UCCR1/positioning-system/hardware/positioning_board.kicad_pcb

## KiCad design hardware/positioning_board.kicad_pcb (2026-02-25)

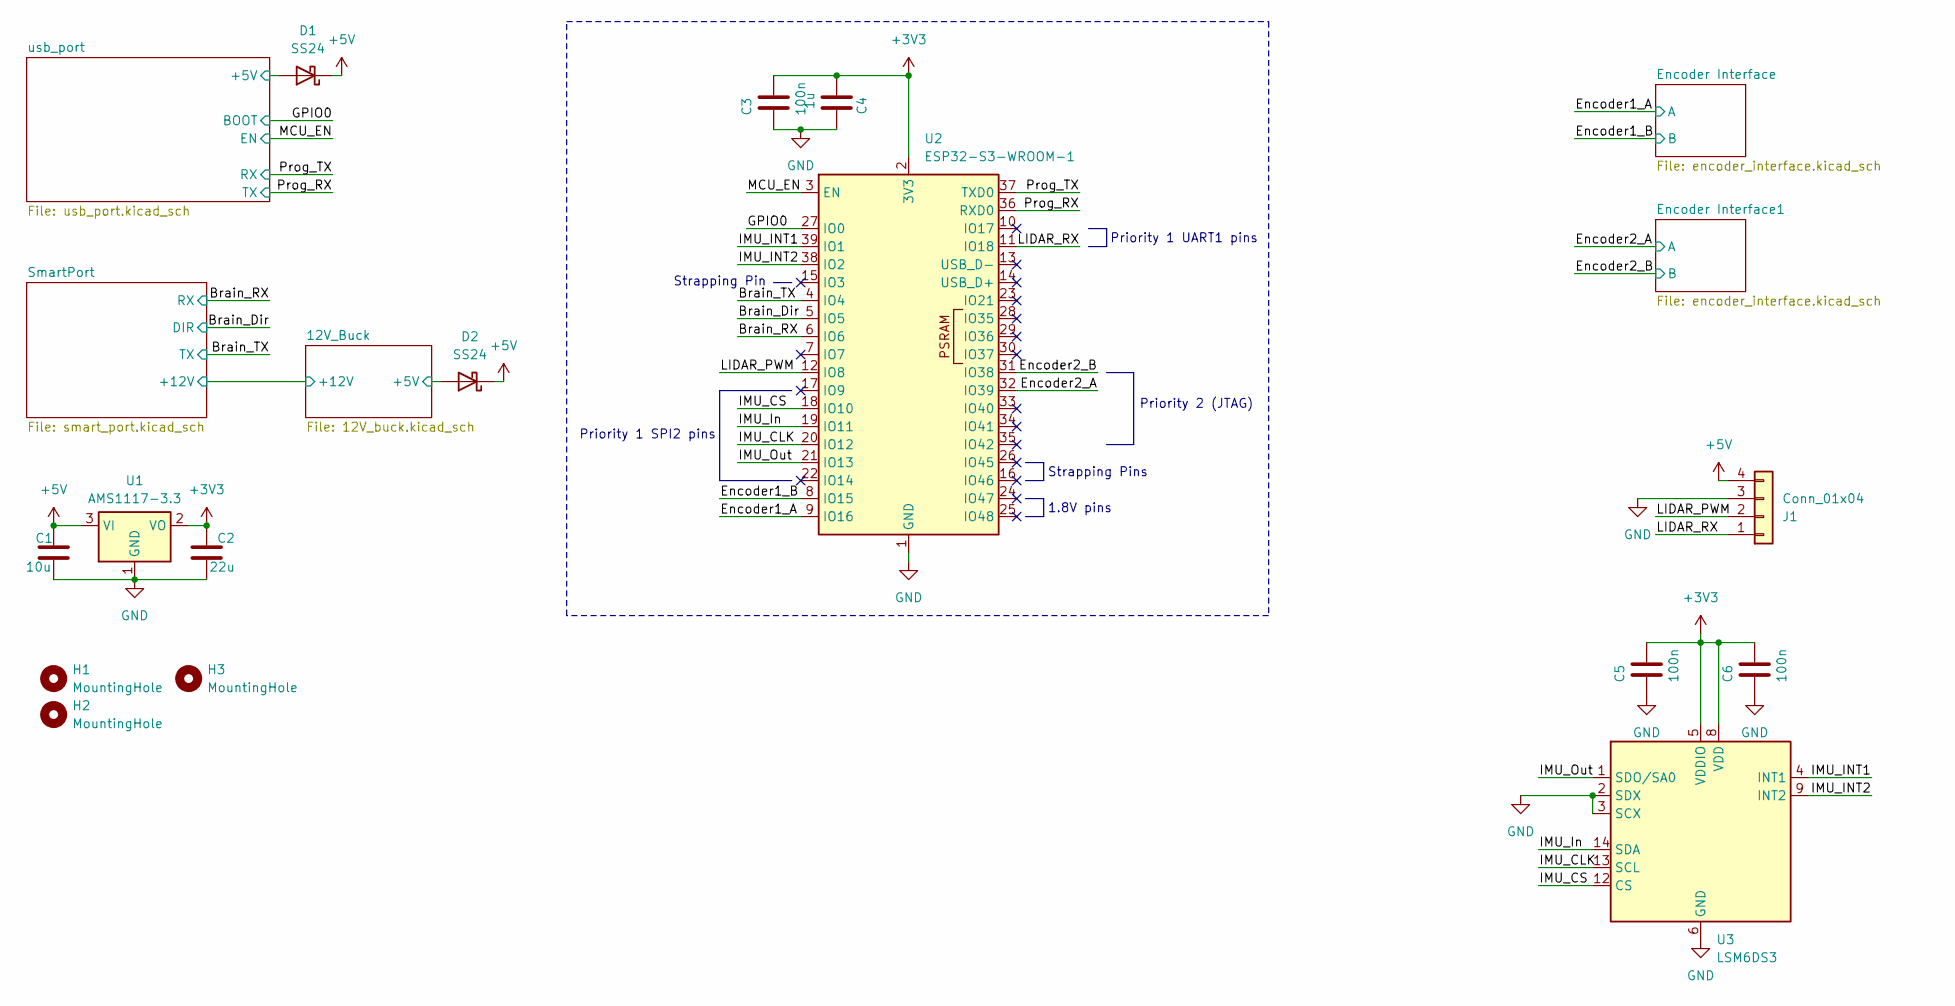
[picture p1: schematic positioning_board.kicad_sch]

Parts:
C1: 10u; C_0603_1608Metric
C2: 22u; C_0603_1608Metric
C3, C5, C6: 100n; C_0603_1608Metric
C4: 1u; C_0603_1608Metric
D1, D2: SS24; D_SMA; LCSC C2891713
H1, H2, H3: MountingHole; MountingHole_4.3mm_M4
J1: Conn_01x04; JST_ZH_B4B-ZR_1x04_P1.50mm_Vertical; LCSC C157997
U1: AMS1117-3.3; SOT-223-3_TabPin2; LCSC C6186
U2: ESP32-S3-WROOM-1; ESP32-S3-WROOM-1U; LCSC C3013946
U3: LSM6DS3; LGA-14_3x2.5mm_P0.5mm_LayoutBorder3x4y

Connections:
+3V3: C2.2, C3.2, C4.1, C5.2, C6.2, U1.2 (VO), U2.2 (3V3), U3.5 (VDDIO), U3.8 (VDD); also elsewhere on the board
+5V: C1.2, D1.1 (K), D2.1 (K), J1.4, U1.3 (VI); also elsewhere on the board
/12V_Buck/+5V: D2.2 (A); also elsewhere on the board
/Brain_Dir: U2.5 (IO5); also elsewhere on the board
/Brain_RX: U2.6 (IO6); also elsewhere on the board
/Brain_TX: U2.4 (IO4); also elsewhere on the board
/Encoder1_A: U2.9 (IO16); also elsewhere on the board
/Encoder1_B: U2.8 (IO15); also elsewhere on the board
/Encoder2_A: U2.32 (IO39); also elsewhere on the board
/Encoder2_B: U2.31 (IO38); also elsewhere on the board
/GPIO0: U2.27 (IO0); also elsewhere on the board
/IMU_CLK: U2.20 (IO12), U3.13 (SCL)
/IMU_CS: U2.18 (IO10), U3.12 (CS)
/IMU_INT1: U2.39 (IO1), U3.4 (INT1)
/IMU_INT2: U2.38 (IO2), U3.9 (INT2)
/IMU_In: U2.19 (IO11), U3.14 (SDA)
/IMU_Out: U2.21 (IO13), U3.1 (SDO/SA0)
/LIDAR_PWM: J1.2, U2.12 (IO8)
/LIDAR_RX: J1.1, U2.11 (IO18)
/MCU_EN: U2.3 (EN); also elsewhere on the board
/Prog_RX: U2.36 (RXD0); also elsewhere on the board
/Prog_TX: U2.37 (TXD0); also elsewhere on the board
/usb_port/+5V: D1.2 (A); also elsewhere on the board
GND: C1.1, C2.1, C3.1, C4.2, C5.1, C6.1, J1.3, U1.1 (GND), U2.1 (GND), U2.40 (GND), U2.41 (GND), U3.2 (SDX), U3.3 (SCX), U3.6 (GND), U3.7 (GND); also elsewhere on the board

Notes on the sheet:
Priority 2 (JTAG)
Strapping Pins
Strapping Pin
Priority 1 UART1 pins
1.8V pins
Priority 1 SPI2 pins

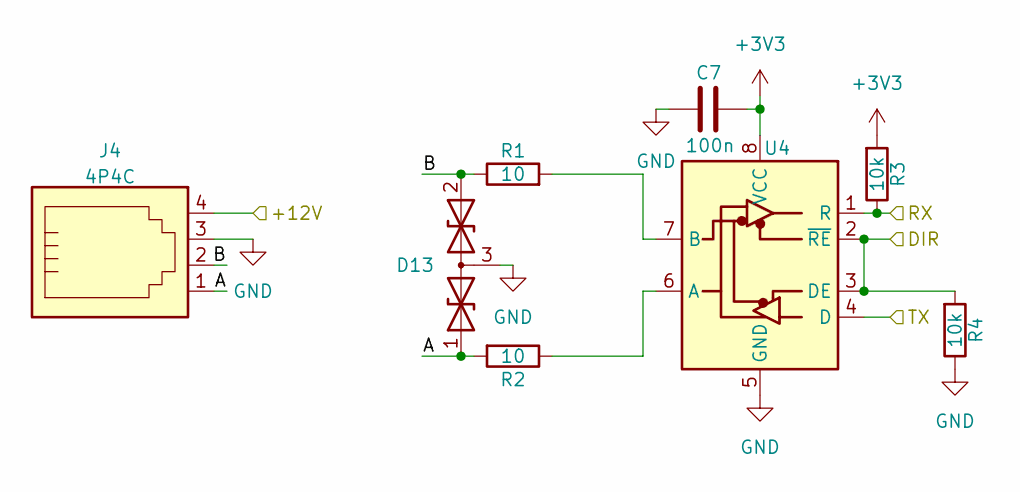
[picture p2: schematic smart_port.kicad_sch]

Parts:
C7: 100n; C_0603_1608Metric
D13: CESD3V3AP; SOT-23
J4: 4P4C; RJ11-4P4C; LCSC C189737
R1, R2: 10; R_0603_1608Metric
R3, R4: 10k; R_0603_1608Metric
U4: SN65HVD1782DR; SOIC-8_3.9x4.9mm_P1.27mm; LCSC C183092

Connections:
+3V3: C7.1, R3.2, U4.8 (VCC); also elsewhere on the board
/12V_Buck/+12V: J4.4; also elsewhere on the board
/Brain_Dir: R4.2, U4.2 (~RE), U4.3 (DE); also elsewhere on the board
/Brain_RX: R3.1, U4.1 (R); also elsewhere on the board
/Brain_TX: U4.4 (D); also elsewhere on the board
/SmartPort/A: D13.1 (A1), J4.1, R2.2
/SmartPort/B: D13.2 (A2), J4.2, R1.1
GND: C7.2, D13.3 (common), J4.3, R4.1, U4.5 (GND); also elsewhere on the board
unnamed: R2.1, U4.6 (A)
unnamed: R1.2, U4.7 (B)

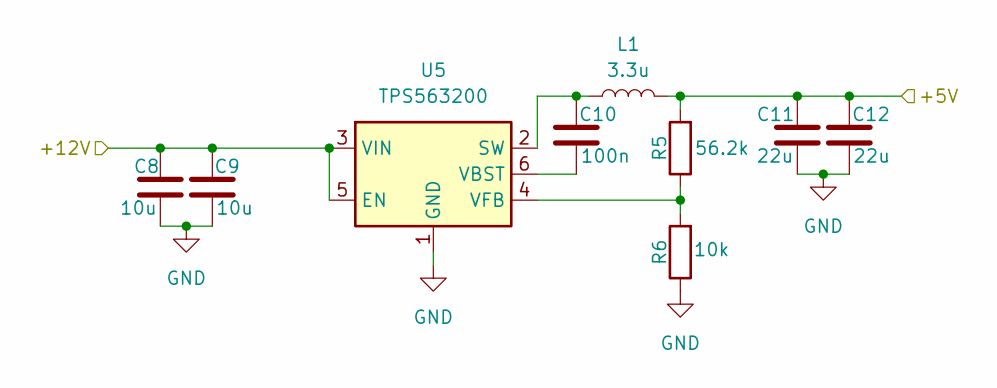
[picture p3: schematic 12V_buck.kicad_sch]

Parts:
C8, C9: 10u; C_0603_1608Metric
C10: 100n; C_0603_1608Metric
C11, C12: 22u; C_0603_1608Metric
L1: 3.3u; L_Changjiang_FXL0630; LCSC C167219
R5: 56.2k; R_0603_1608Metric
R6: 10k; R_0603_1608Metric
U5: TPS563200; SOT-23-6

Connections:
/12V_Buck/+5V: C11.2, C12.2, L1.2, R5.2; also elsewhere on the board
/12V_Buck/+12V: C8.2, C9.2, U5.3 (VIN), U5.5 (EN); also elsewhere on the board
GND: C8.1, C9.1, C11.1, C12.1, R6.1, U5.1 (GND); also elsewhere on the board
unnamed: C10.2, L1.1, U5.2 (SW)
unnamed: C10.1, U5.6 (VBST)
unnamed: R5.1, R6.2, U5.4 (VFB)

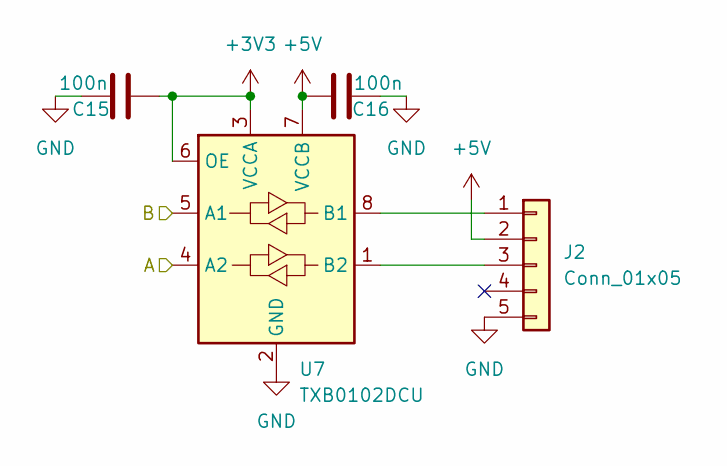
[picture p4: schematic encoder_interface.kicad_sch]

Parts:
C15, C16: 100n; C_0603_1608Metric
J2: Conn_01x05; JST_XH_S5B-XH-A_1x05_P2.50mm_Horizontal
U7: TXB0102DCU; VSSOP-8_2.3x2mm_P0.5mm

Connections:
+3V3: C15.1, U7.3 (VCCA), U7.6 (OE); also elsewhere on the board
+5V: C16.1, J2.2, U7.7 (VCCB); also elsewhere on the board
/Encoder1_A: U7.4 (A2); also elsewhere on the board
/Encoder1_B: U7.5 (A1); also elsewhere on the board
GND: C15.2, C16.2, J2.5, U7.2 (GND); also elsewhere on the board
unnamed: J2.1, U7.8 (B1)
unnamed: J2.3, U7.1 (B2)

Parts of its further copies:
C17, C18: 100n; C_0603_1608Metric
J3: Conn_01x05; JST_XH_S5B-XH-A_1x05_P2.50mm_Horizontal
U8: TXB0102DCU; VSSOP-8_2.3x2mm_P0.5mm

Connections of its further copies:
+3V3: C17.1, U8.3 (VCCA), U8.6 (OE); also elsewhere on the board
+5V: C18.1, J3.2, U8.7 (VCCB); also elsewhere on the board
/Encoder2_A: U8.4 (A2); also elsewhere on the board
/Encoder2_B: U8.5 (A1); also elsewhere on the board
GND: C17.2, C18.2, J3.5, U8.2 (GND); also elsewhere on the board
unnamed: J3.1, U8.8 (B1)
unnamed: J3.3, U8.1 (B2)

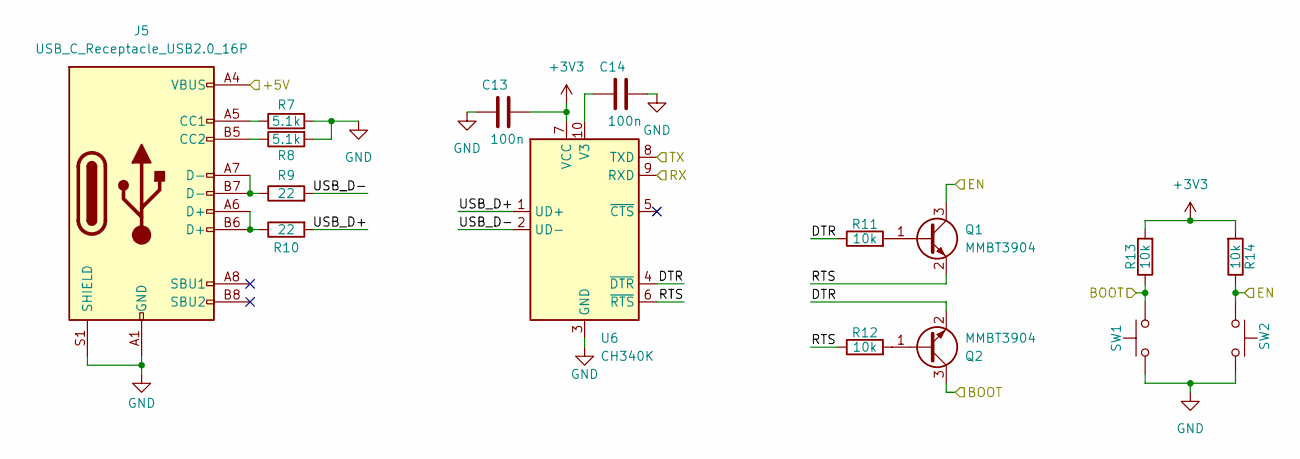
[picture p5: schematic usb_port.kicad_sch]

Parts:
C13, C14: 100n; C_0603_1608Metric
J5: USB_C_Receptacle_USB2.0_16P; USB_C_Receptacle_GCT_USB4105-xx-A_16P_TopMnt_Horizontal; LCSC C2927038
Q1, Q2: MMBT3904; SOT-23; LCSC C20526
R7, R8: 5.1k; R_0603_1608Metric
R9, R10: 22; R_0603_1608Metric
R11, R12, R13, R14: 10k; R_0603_1608Metric
SW1, SW2: SW_Push; SW_SPST_TS-1088-xR020; LCSC C720477
U6: CH340K; SSOP-10-1EP_3.9x4.9mm_P1mm_EP2.1x3.3mm; LCSC C968586

Connections:
+3V3: C13.2, R13.2, R14.2, U6.7 (VCC); also elsewhere on the board
/GPIO0: Q2.3 (C), R13.1, SW1.2; also elsewhere on the board
/MCU_EN: Q1.3 (C), R14.1, SW2.2; also elsewhere on the board
/Prog_RX: U6.8 (TXD); also elsewhere on the board
/Prog_TX: U6.9 (RXD); also elsewhere on the board
/usb_port/+5V: J5.A4 (VBUS), J5.A9 (VBUS), J5.B4 (VBUS), J5.B9 (VBUS); also elsewhere on the board
/usb_port/DTR: Q2.2 (E), R11.1, U6.4 (~DTR)
/usb_port/RTS: Q1.2 (E), R12.1, U6.6 (~RTS)
/usb_port/USB_D+: R10.2, U6.1 (UD+)
/usb_port/USB_D-: R9.2, U6.2 (UD-)
GND: C13.1, C14.2, J5.A1 (GND), J5.A12 (GND), J5.B1 (GND), J5.B12 (GND), J5.S1 (SHIELD), R7.2, R8.2, SW1.1, SW2.1, U6.3 (GND), U6.11 (GND); also elsewhere on the board
unnamed: J5.A5 (CC1), R7.1
unnamed: J5.B5 (CC2), R8.1
unnamed: J5.A6 (D+), J5.B6 (D+), R10.1
unnamed: J5.A7 (D-), J5.B7 (D-), R9.1
unnamed: Q1.1 (B), R11.2
unnamed: Q2.1 (B), R12.2
unnamed: C14.1, U6.10 (V3)

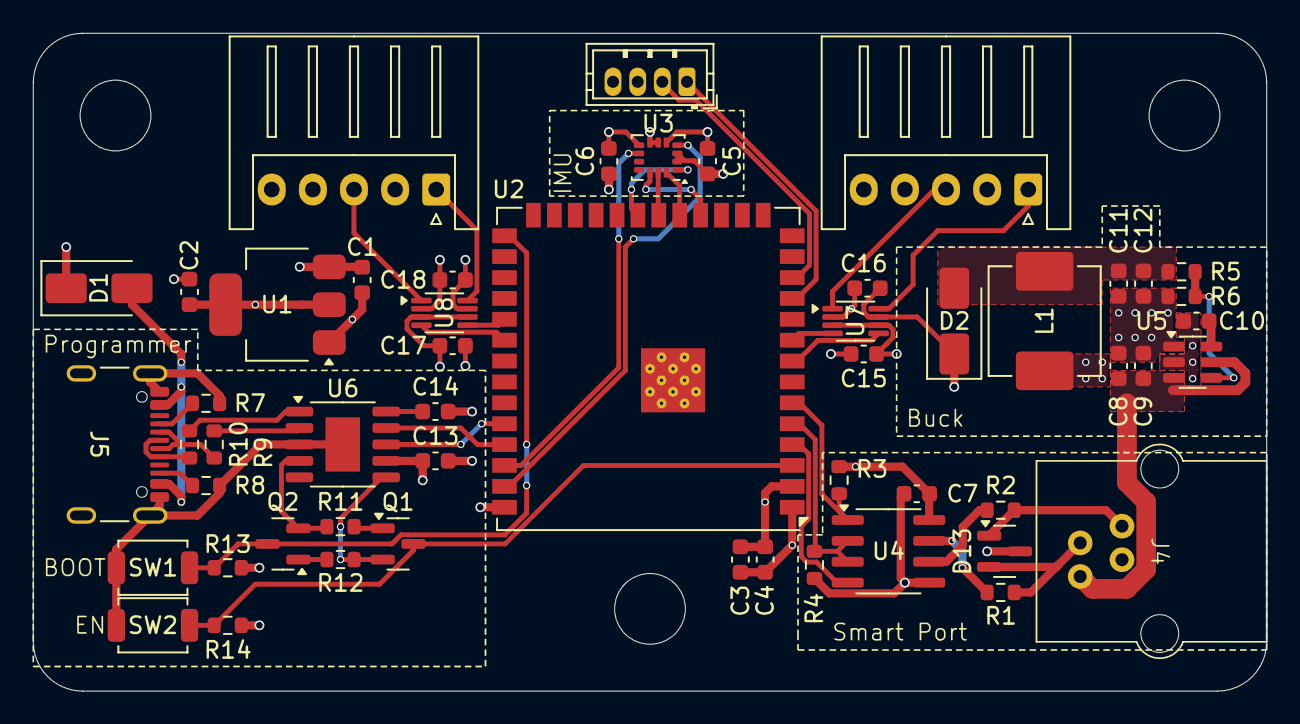
[picture p6: board positioning_board.kicad_pcb from above]

Board: 4 copper layers, 75.0 x 40.0 mm, 56 parts (0 on the bottom side), 47 nets.
