UCCR1/positioning-system/firmware/src/odometry.rs

use core::array;

use embassy_time::Timer;
use position_lib::odometry::{Odometry, TrackingWheel};
use uom::si::f32::{Angle, Length};

use crate::{encoder::QuadratureEncoder, imu::HEADING_SIGNAL};

pub struct OdometryTask<const N: usize> {
    module: Odometry<N>,

    wheel_diameter: Length,

    encoders: [QuadratureEncoder; N],
    last_angle: Angle,

    last_positions: [Angle; N],
}

impl<const N: usize> OdometryTask<N> {
    pub fn new(
        encoders: [QuadratureEncoder; N],
        wheels: [TrackingWheel; N],
        wheel_diameter: Length,
    ) -> Self {
        let module = Odometry::new(wheels);

        Self {
            module,
            encoders,
            wheel_diameter,

            last_angle: Default::default(),
            last_positions: [Default::default(); N],
        }
    }

    fn update(&mut self, new_angle: Angle) {
        let new_positions: [Angle; N] = array::from_fn(|i| self.encoders[i].position());

        let travels: [Length; N] = array::from_fn(|i| {
            (new_positions[i] - self.last_positions[i]) * self.wheel_diameter / 2.0
        });

        let angle_change = self.last_angle - new_angle; // TODO: Wrap this properly

        self.module.update(travels, angle_change);

        self.last_angle = new_angle;
        self.last_positions = new_positions;
    }

    pub async fn entrypoint(mut self) {
        loop {
            Timer::after_millis(10).await;

            let angle = HEADING_SIGNAL.wait().await;

            self.update(angle);
        }
    }
}

#[embassy_executor::task]
pub async fn start_odometry_task(task: OdometryTask<2>) {
    task.entrypoint().await;
}
