UCCR1/positioning-system/(commit log)

2026-02-11 add initial hardware
    [positioning_board.kicad_pcb, positioning_board.kicad_sch]
2026-02-23 feat: draft layout
    [positioning_board.kicad_pcb, positioning_board.kicad_sch]
2026-02-23 reroute lidar pins
    [positioning_board.kicad_pcb, positioning_board.kicad_sch]
2026-02-23 reroute some pins
    [positioning_board.kicad_pcb, positioning_board.kicad_sch]
2026-02-24 refactor into sub sheets
    [12V_buck.kicad_sch, positioning_board.kicad_sch, smart_port.kicad_sch, usb_port.kicad_sch]
2026-02-24 relayout board
    [positioning_board.kicad_pcb, positioning_board.kicad_sch, smart_port.kicad_sch, usb_port.kicad_sch]
2026-02-24 swap lidar and brain UART channels
    [positioning_board.kicad_pcb, positioning_board.kicad_sch]
2026-02-24 switch to 4 layer
    [positioning_board.kicad_pcb]
2026-02-24 optimize size
    [positioning_board.kicad_pcb]
2026-02-24 fix programmer differential routing
    [positioning_board.kicad_pcb]
2026-02-24 add empty space around holes
    [positioning_board.kicad_pcb]
2026-02-24 fix: remove traces from underneath IMU
    [positioning_board.kicad_pcb]
2026-02-24 add back labels
    [positioning_board.kicad_pcb]
2026-02-25 add logic level shifters
    [encoder_interface.kicad_sch, positioning_board.kicad_pcb, positioning_board.kicad_sch]
2026-03-03 generic N wheel odom
2026-03-04 encoder counter barebones
2026-03-04 initial multi encoder impl
2026-03-04 refactor: switch back to atomics
2026-03-12 feat: linear algebra N wheel solution
2026-03-12 feat: lidar packet parser
2026-03-12 feat: encoder angle position import odom into firmware
2026-03-12 feat: macro encoder definition
2026-03-12 feat: impl odometry task
2026-03-12 feat: uart lidar parsing
2026-03-12 reduce encoder macro size
2026-03-13 Added generic sensor trait
2026-03-13 feat: imu register behavior
2026-03-14 feat: Imu task
2026-03-14 fix: encoders not wrapping negative
    [encoder.rs]
2026-04-03 initial imu integration
2026-04-03 refactor: extract imu logic to own crate
2026-04-04 feat: test circuit code
2026-04-04 feat: calibration
2026-04-04 feat: interrupt based gyro polling
2026-04-04 feat: generic calibration struct
2026-04-04 fix: proper sensitivity for both imu modules
    [lib.rs, lsm6ds3tr.rs, lsm6dsv.rs]
2026-04-13 refactor: seperate angular velocity and linear acceleration traits
2026-04-13 refactor: extract angular position integration to imu-lib
2026-04-13 refactor: consolidate calibration and integration
2026-04-13 refactor: rename modules to devices
2026-04-13 feat: linear position/velocity integration
